blinry/co2-canary/hardware/co2-sensor.kicad_pcb

## KiCad design hardware/co2-sensor.kicad_pcb (2024-11-22)

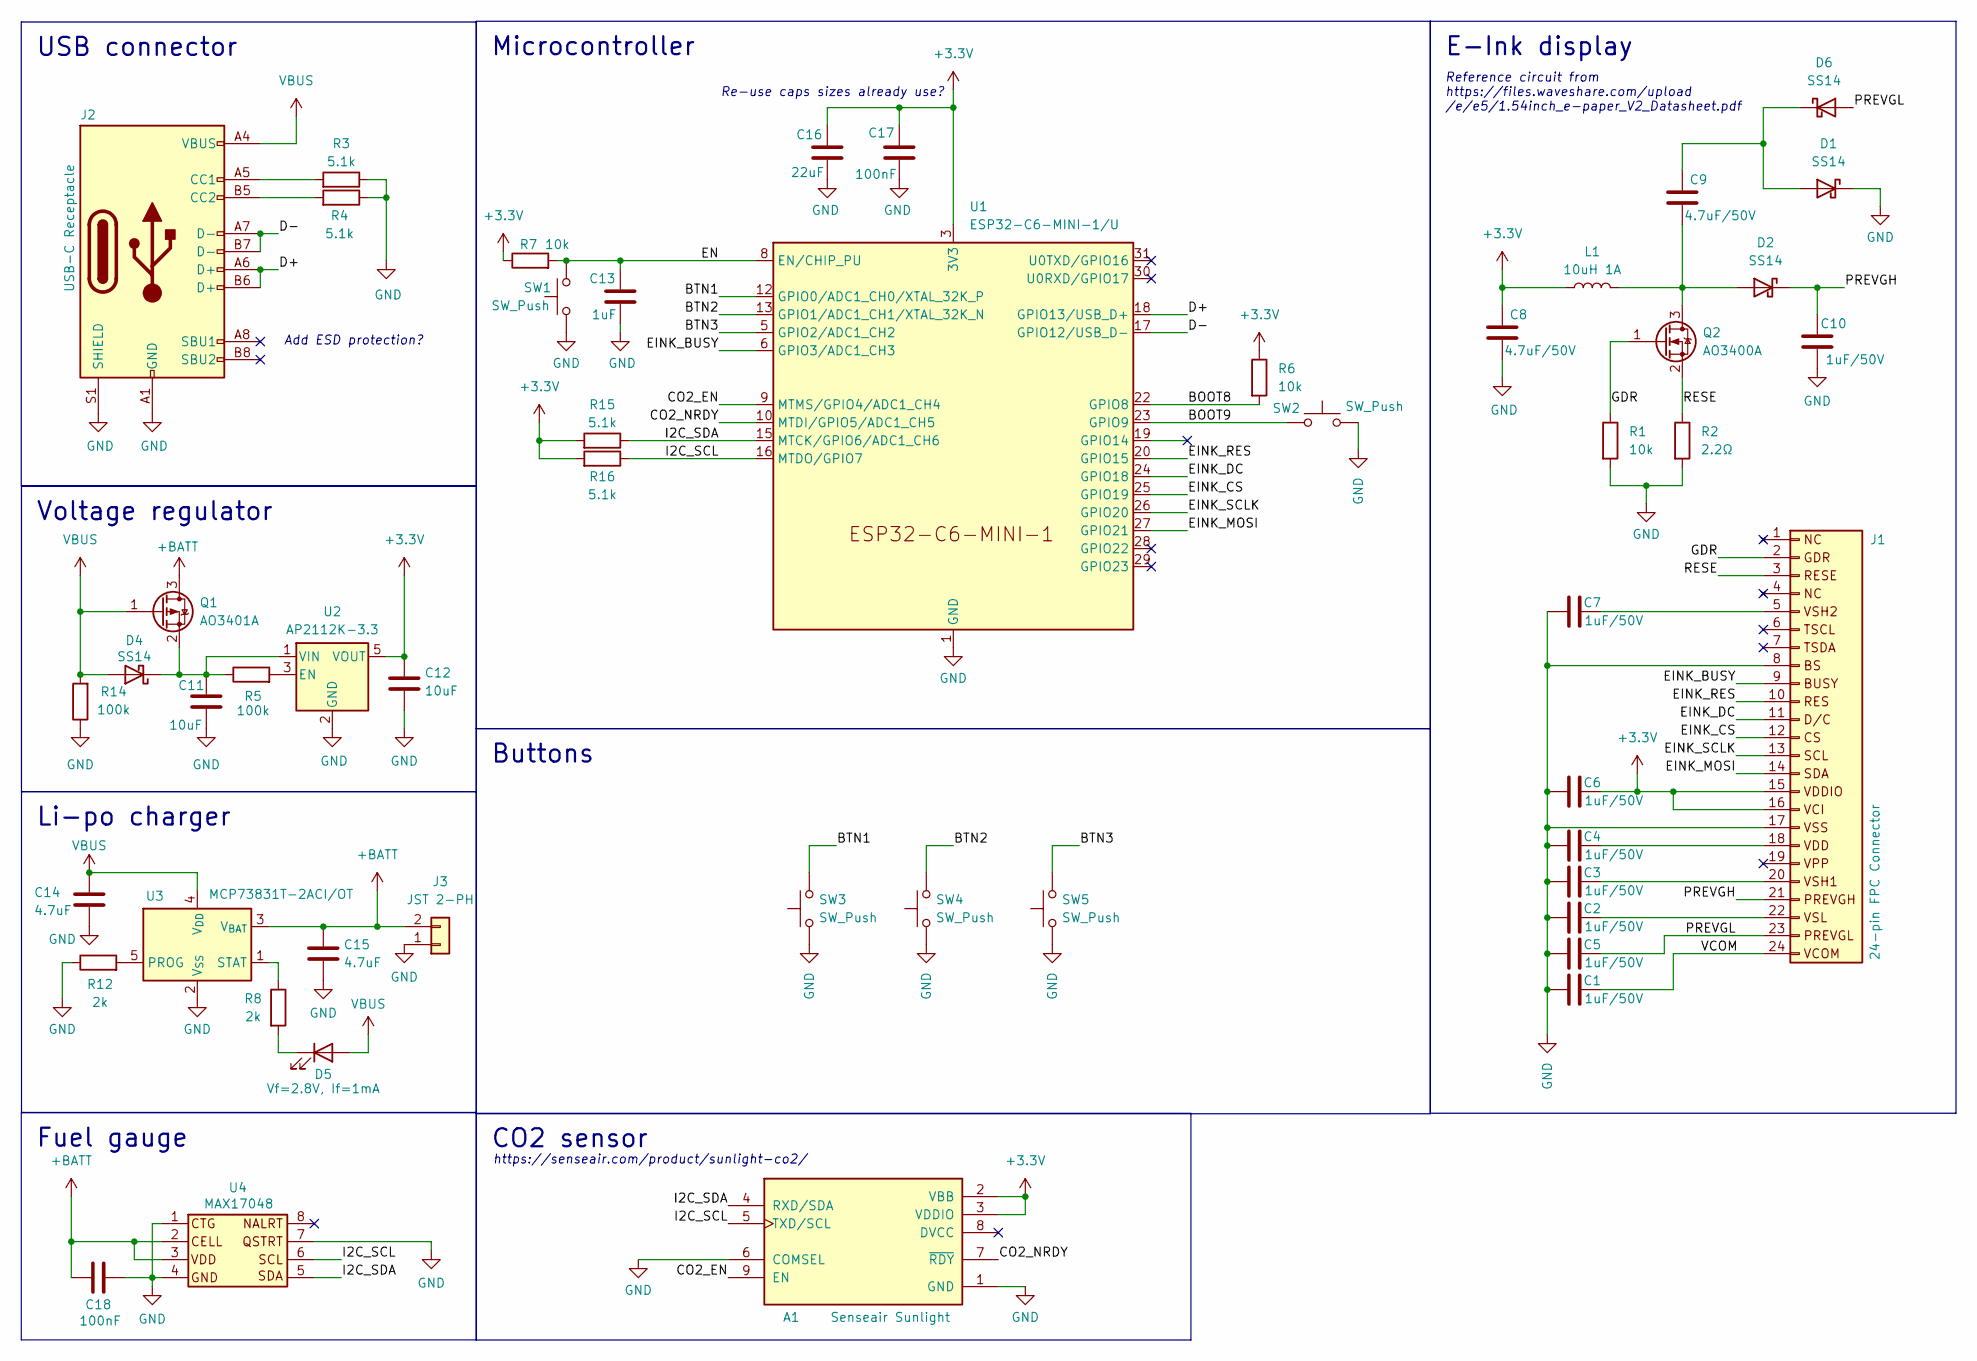
[picture p1: schematic co2-sensor.kicad_sch, Low-Power CO2 Sensor]

Parts:
A1: Senseair Sunlight; Senseair_Sunrise; PARTREV 1.00.000
C1, C2, C3, C4, C5, C6, C7, C10: 1uF/50V; C_0603_1608Metric; LCSC Part C15849
C8, C9: 4.7uF/50V; C_1206_3216Metric; LCSC Part C29823
C11, C12: 10uF; C_0603_1608Metric; LCSC Part C96446
C13: 1uF; C_0603_1608Metric; LCSC Part C15849
C14, C15: 4.7uF; C_1206_3216Metric; LCSC Part C29823
C16: 22uF; C_0805_2012Metric; LCSC Part C45783
C17, C18: 100nF; C_0805_2012Metric; LCSC Part C1710
D1, D2, D4, D6: SS14; D_SOD-123; LCSC Part C8598
D5: Vf=2.8V, If=1mA; LED_0603_1608Metric; LCSC Part C2290
J1: 24-pin FPC Connector; Jushuo_AFC07-S24FCA-00_1x24-1MP_P0.50_Horizontal; LCSC Part C262567
J2: USB-C Receptacle; USB_C_Receptacle_G-Switch_GT-USB-7010ASV; LCSC Part C2988369
J3: JST 2-PH; JST_PH_S2B-PH-SM4-TB_1x02-1MP_P2.00mm_Horizontal; LCSC Part C7433648
L1: 10uH 1A; L_1008_2520Metric; LCSC Part C602018
Q1: AO3401A; SOT-23; LCSC Part C15127
Q2: AO3400A; SOT-23; LCSC Part C20917
R1, R6, R7: 10k; R_0603_1608Metric; LCSC Part C25804
R2: 2.2Ω; R_0603_1608Metric; LCSC Part C22939
R3, R4, R15, R16: 5.1k; R_0603_1608Metric; LCSC Part C23186
R5, R14: 100k; R_0402_1005Metric; LCSC Part C25741
R8, R12: 2k; R_0402_1005Metric; LCSC Part C4109
SW1, SW2, SW3, SW4, SW5: SW_Push; SW_Push_1P1T_XKB_TS-1187A; LCSC Part C318884
U1: ESP32-C6-MINI-1/U; ESP32-C6-MINI-1; LCSC Part C5736265
U2: AP2112K-3.3; SOT-23-5; LCSC Part C51118
U3: MCP73831T-2ACI/OT; SOT-23-5; LCSC Part C424093
U4: MAX17048; DFN-8-1EP_2x2mm_P0.5mm_EP1.05x1.75mm; LCSC Part C2682616

Connections:
+3.3V: A1.2 (VBB), A1.3 (VDDIO), C6.2, C8.2, C12.1, C16.2, C17.2, J1.15, J1.16, L1.1, R6.1, R7.1, R15.2, R16.2, U1.3 (3V3), U2.5 (VOUT)
+BATT: C15.1, C18.2, J3.2, Q1.3 (D), U3.3 (V_{BAT}), U4.2, U4.3
/BOOT8: R6.2, U1.22 (GPIO8)
/BOOT9: SW2.2, U1.23 (GPIO9)
/BTN1: SW3.2, U1.12 (GPIO0/ADC1_CH0/XTAL_32K_P)
/BTN2: SW4.2, U1.13 (GPIO1/ADC1_CH1/XTAL_32K_N)
/BTN3: SW5.2, U1.5 (GPIO2/ADC1_CH2)
/CO2_EN: A1.9 (EN), U1.9 (MTMS/GPIO4/ADC1_CH4)
/CO2_NRDY: A1.7 (~RDY), U1.10 (MTDI/GPIO5/ADC1_CH5)
/D+: J2.A6 (D+), J2.B6 (D+), U1.18 (GPIO13/USB_D+)
/D-: J2.A7 (D-), J2.B7 (D-), U1.17 (GPIO12/USB_D-)
/EINK_BUSY: J1.9, U1.6 (GPIO3/ADC1_CH3)
/EINK_CS: J1.12, U1.25 (GPIO19)
/EINK_DC: J1.11, U1.24 (GPIO18)
/EINK_MOSI: J1.14, U1.27 (GPIO21)
/EINK_RES: J1.10, U1.20 (GPIO15)
/EINK_SCLK: J1.13, U1.26 (GPIO20)
/EN: C13.2, R7.2, SW1.2, U1.8 (EN/CHIP_PU)
/GDR: J1.2, Q2.1 (G), R1.1
/I2C_SCL: A1.5 (TXD/SCL), R16.1, U1.16 (MTDO/GPIO7), U4.6
/I2C_SDA: A1.4 (RXD/SDA), R15.1, U1.15 (MTCK/GPIO6/ADC1_CH6), U4.5
/PREVGH: C10.2, D2.1 (K), J1.21
/PREVGL: C5.2, D6.2 (A), J1.23
/RESE: J1.3, Q2.2 (S), R2.1
/VCOM: C1.2, J1.24
GND: A1.1 (GND), A1.6 (COMSEL), C1.1, C2.1, C3.1, C4.1, C5.1, C6.1, C7.1, C8.1, C10.1, C11.2, C12.2, C13.1, C14.2, C15.2, C16.1, C17.1, C18.1, D1.1 (K), J1.8, J1.17, J2.A1 (GND), J2.A12 (GND), J2.B1 (GND), J2.B12 (GND), J2.S1 (SHIELD), J3.1, R1.2, R2.2, R3.1, R4.1, R12.1, R14.1, SW1.1, SW2.1, SW3.1, SW4.1, SW5.1, U1.1 (GND), U1.2 (GND), U1.11 (GND), U1.14 (GND), U1.36 (GND), U1.37 (GND), U1.38 (GND), U1.39 (GND), U1.40 (GND), U1.41 (GND), U1.42 (GND), U1.43 (GND), U1.44 (GND), U1.45 (GND), U1.46 (GND), U1.47 (GND), U1.48 (GND), U1.49 (GND), U1.50 (GND), U1.51 (GND), U1.52 (GND), U1.53 (GND), U2.2 (GND), U3.2 (V_{SS}), U4.1, U4.4, U4.7
unnamed: C9.2, D1.2 (A), D6.1 (K)
unnamed: C9.1, D2.2 (A), L1.2, Q2.3 (D)
unnamed: C11.1, D4.1 (K), Q1.2 (S), R5.1, U2.1 (VIN)
unnamed: D5.1 (K), R8.2
unnamed: C7.2, J1.5
unnamed: C4.2, J1.18
unnamed: C3.2, J1.20
unnamed: C2.2, J1.22
unnamed: J2.A5 (CC1), R3.2
unnamed: J2.B5 (CC2), R4.2
unnamed: R5.2, U2.3 (EN)
unnamed: R12.2, U3.5 (PROG)
unnamed: R8.1, U3.1 (STAT)
VBUS: C14.1, D4.2 (A), D5.2 (A), J2.A4 (VBUS), J2.A9 (VBUS), J2.B4 (VBUS), J2.B9 (VBUS), Q1.1 (G), R14.2, U3.4 (V_{DD})

Notes on the sheet:
Fuel gauge
Buttons
USB connector
Voltage regulator
Microcontroller
E-Ink display
Li-po charger
CO2 sensor
https://senseair.com/product/sunlight-co2/
Add ESD protection?
Re-use caps sizes already use?
Reference circuit from https://files.waveshare.com/upload /e/e5/1.54inch_e-paper_V2_Datasheet.pdf

Board: 2 copper layers, 51 parts (0 on the bottom side), 40 nets, no tracks yet.
