blinry/co2-canary/firmware/src/history.rs

use core::slice::Windows;
use heapless::HistoryBuffer;

/*pub struct Measurement {
    value: u16,
    time: u64, // TODO: use a proper time type
}*/

const HISTORY_SIZE: usize = 60 * 6 * 2; // values

pub struct History {
    values: HistoryBuffer<u16, HISTORY_SIZE>,
}

impl History {
    pub const fn new() -> Self {
        History {
            values: HistoryBuffer::new(),
        }
    }

    pub fn add_measurement(&mut self, measurement: u16) {
        self.values.write(measurement);
    }

    pub fn recent(&self) -> Option<u16> {
        self.values.recent().copied()
    }

    pub fn iter(&self) -> impl Iterator<Item = &u16> {
        self.values.oldest_ordered()
    }

    pub fn len(&self) -> usize {
        self.values.len()
    }

    pub fn max_value(&self) -> Option<u16> {
        self.values.iter().max().copied()
    }

    pub fn windows_2(&self) -> Windows<u16> {
        self.values.windows(2)
    }

    pub fn max_size() -> usize {
        HISTORY_SIZE
    }
}
