blinry/co2-canary/(commit log)

2024-01-12 Access Sunrise sensor via I2C
2024-01-16 Try to print CO2 value
2024-02-01 Update flake to a working state, thanks to knarkzel/esp32!
2024-02-02 Switch to small screen and clean up code
2024-02-03 Allow caller of CO2 sensor to light sleep
2024-02-04 Implement automatic background calibration
2024-02-04 Add temperature display
2024-02-04 Increase SPI and I2C frequencies
2024-02-04 Display battery voltage
2024-02-10 Another guess for the battery factor. Maybe this one's better?
2024-10-19 System time is in microseconds, not milliseconds!
2024-10-20 Add 0 measurements if CO2 measurement fails
    [main.rs]
2024-10-21 Fix graph display, keep same time-per-pixel in graph
    [display.rs, history.rs]
2024-10-25 Try to adapt to ESP32-C6, not working yet
    [main.rs, sunrise.rs]
2024-10-28 Make I2C work again
2024-10-28 Display battery percentage
2024-10-30 Initial commit, half-finished design with Feather
    [co2-sensor.kicad_pcb, co2-sensor.kicad_sch]
2024-10-31 Rework to use ESP32 module directly
    [co2-sensor.kicad_pcb, co2-sensor.kicad_sch]
2024-11-01 Polish before getting feedback
    [co2-sensor.kicad_sch]
2024-11-19 Add charging LED, make all wakeup sources trigger down
    [co2-sensor.kicad_sch]
2024-11-19 Add .gitignore and some files I'm not sure I need to track
2024-11-19 Before manual de-bolding fix
    [co2-sensor.kicad_sch]
2024-11-19 Update PCB from schematic
    [co2-sensor.kicad_pcb]
2024-11-20 First test export
    [co2-sensor.kicad_pcb]
2024-11-21 Add all LCSC part numbers
    [co2-sensor.kicad_pcb, co2-sensor.kicad_sch]
2024-11-21 Move components around
    [co2-sensor.kicad_pcb, co2-sensor.kicad_sch]
2024-11-22 Move around some more
    [co2-sensor.kicad_pcb]
2025-02-27 Rename variables to be more semantically correct
    [display.rs, main.rs]
2025-02-27 Switch to max170xx crate, because it uses embedded_hal 1.0
2025-02-28 Move KiCad design to hardware/ subdirectory
    [co2-sensor.kicad_pcb, co2-sensor.kicad_sch]
